lutzer/bongoForest/README.md

# BONGO FOREST

### Important

* Dont run arduino pros on more than 5 V on the RAW Pin. use seperate voltage regulator or **they will burn**.
