lutzer/bongoForest/dev/platformio/remote_direct_control/README.md

# Direct RF Control

* ID can be specified in platformio.ini as build flags

#### Upload

```bash
$ pio run --target upload
```

#### Monitoring

```bash
$ pio device monitor
```
