lutzer/bongoForest/dev/platformio/slave_drum/README.md

# Slave Drum Receiver

* ID and type of the drum can be specified in platformio.ini as build flags

#### Upload

```bash
$ pio run --target upload
```

#### Monitoring

```bash
$ pio device monitor
```
