lutzer/bongoForest/dev/platformio/master_drum/README.md

# Master Drum Sensor and RF Sender

#### Upload

```bash
$ pio run --target upload
```

#### Monitoring

```bash
$ pio device monitor
```
