lutzer/bongoForest/docs/solenoid.md

# Solenoids

### how to connect

https://www.bc-robotics.com/tutorials/controlling-a-solenoid-valve-with-arduino/

#### BOM

- 1 x [TIP120 Darlington Transistor](https://www.bc-robotics.com/shop/tip120-darlington-transistor/)
- 1 x [1K Ohm Resistor](https://www.bc-robotics.com/shop/14-watt-resistor/)
- 1 x [1N4001 Diode](https://www.bc-robotics.com/shop/diode-rectifier-1a-50v/)
