lutzer/bongoForest/docs/BOM.md

# BOM

## Slave pcbs

* [ ] 10 pin header female  2x4
* [ ] 20 pin header female 1x12
* [ ] 10 x arduino pro mini 3.3V
* [ ] 10x nrf240L radio transceiver
* [ ] 20x TIP120
* [ ] 20x Voltage Regulator
* [ ] 20x 1kOhm Resistors
* [ ] 10x Diode
* [ ] 10x Schotky diode
* [ ] 40x Leds + Resistors
* [ ] 10x 10uF Capacitor
* [ ] Strom schraub verbinder
* [ ] 20x pin header male 1x2

### Drums

Solenoids
