lutzer/bongoForest/pcbs/slave_drum/bom_for_slaves.md

# BOM for slave pcbs

* [ ] 1 pin header female  2x4
* [ ] 2 pin header female 1x12
* [ ] 1 x arduino pro mini 3.3V
* [ ] 1 nrf240L radio transceiver
* [ ] 2 TIP120
* [ ] 1 Voltage Regulator
* [ ] 2 1kOhm Resistors
* [ ] 1 Diode
* [ ] 2 Schotky diode
* [ ] 4 Leds + Resistors
* [ ] 1 10uF Capacitor
* [ ] Screw Terminal 2pin
* [ ] 2 pin header male 1x2
