lutzer/bongoForest/stls/pcb_case_top_rotated.stl

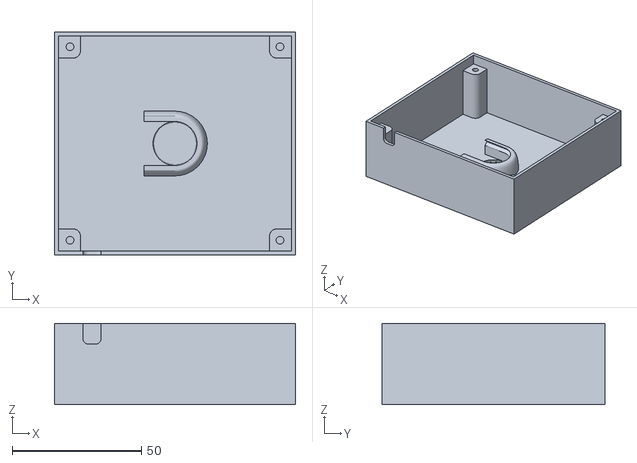
[picture p3: CAD file, 2018-07-22]
stls/pcb_case_top_rotated.stl
93.2 x 86.2 x 31.5
