lutzer/bongoForest/stls/Piezzo_clamp_v1.stl

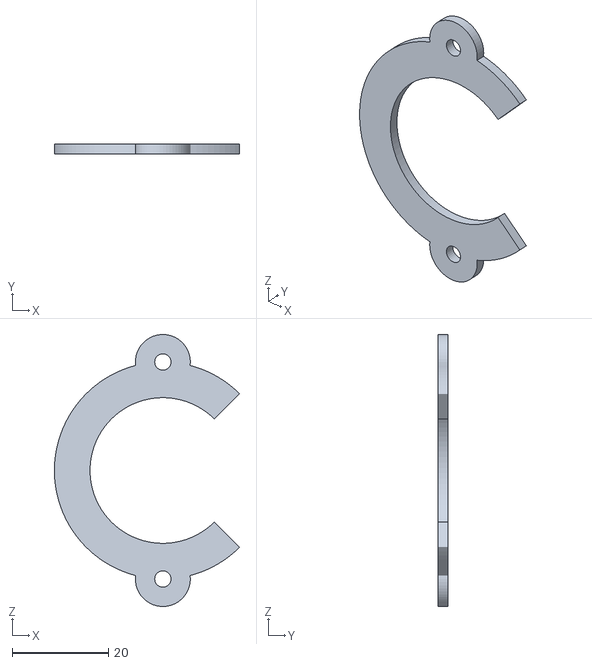
[picture p4: CAD file, 2018-07-22]
stls/Piezzo_clamp_v1.stl
38.4 x 2.00 x 56.4
