lutzer/bongoForest/stls/Piezzo_platform_v1.stl

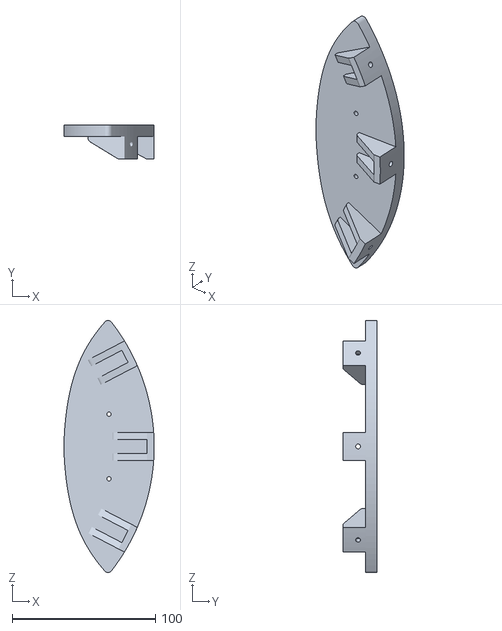
[picture p5: CAD file, 2018-07-22]
stls/Piezzo_platform_v1.stl
63.0 x 24.0 x 175.6
