lutzer/bongoForest/stls/pcb_case_bottom.stl

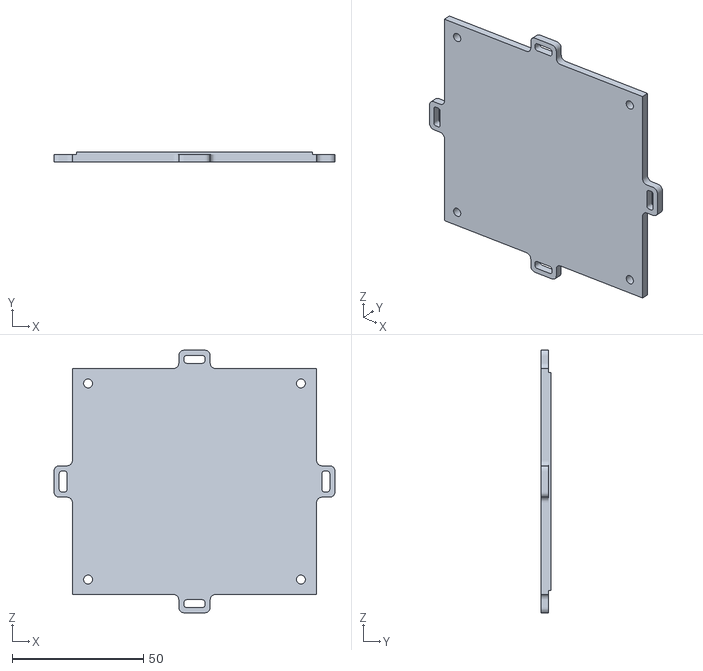
[picture p6: CAD file, 2018-07-21]
stls/pcb_case_bottom.stl
107.2 x 4.00 x 100.2
