lutzer/bongoForest/stls/clamp_14.stl

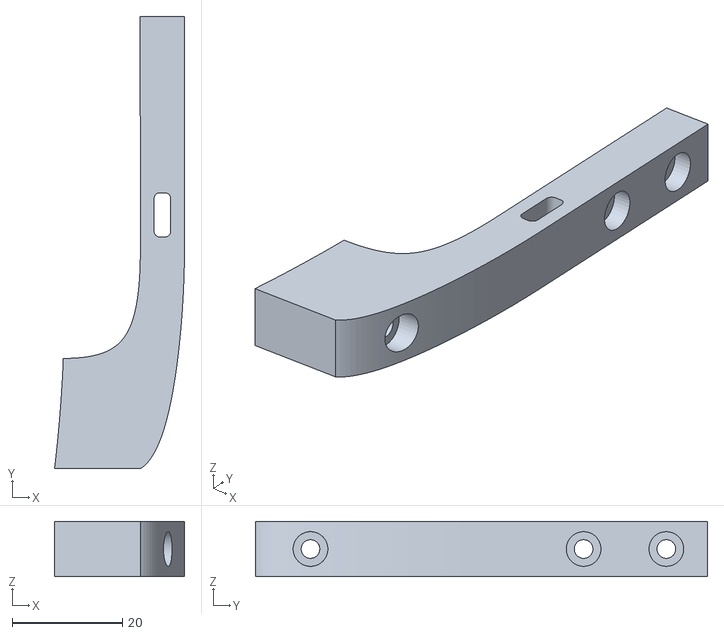
[picture p7: CAD file, 2018-07-21]
stls/clamp_14.stl
23.6 x 82.0 x 10.0
