lutzer/bongoForest/stls/holder_125mm.stl

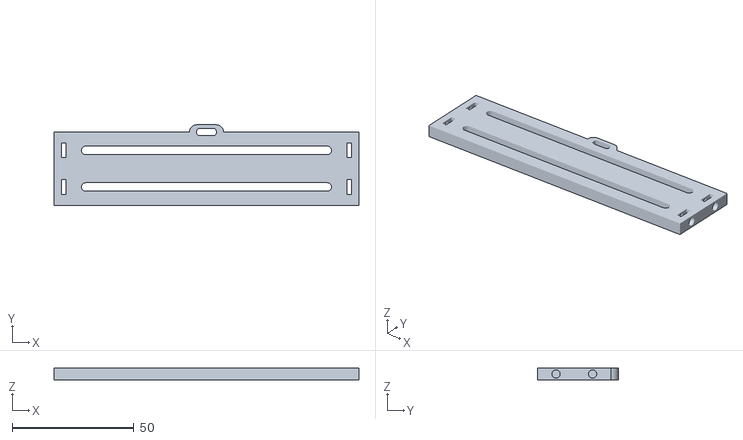
[picture p8: CAD file, 2018-07-21]
stls/holder_125mm.stl
125.0 x 33.0 x 5.00
