lutzer/bongoForest/stls/holder_116mm.stl

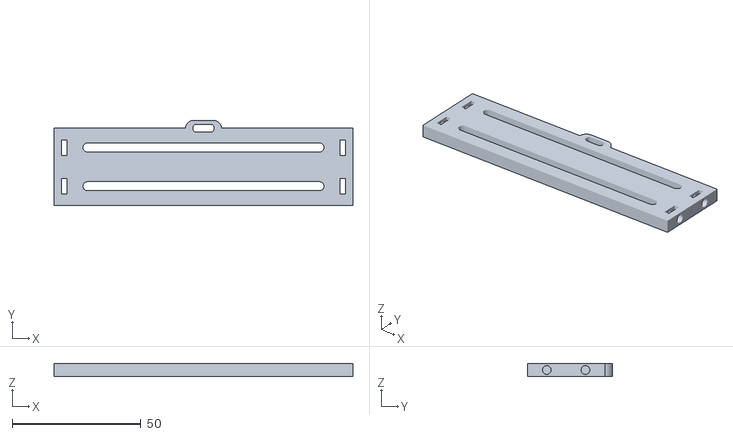
[picture p9: CAD file, 2018-06-27]
stls/holder_116mm.stl
116.0 x 33.0 x 5.00
