lutzer/bongoForest/stls/clamp_10mm.stl

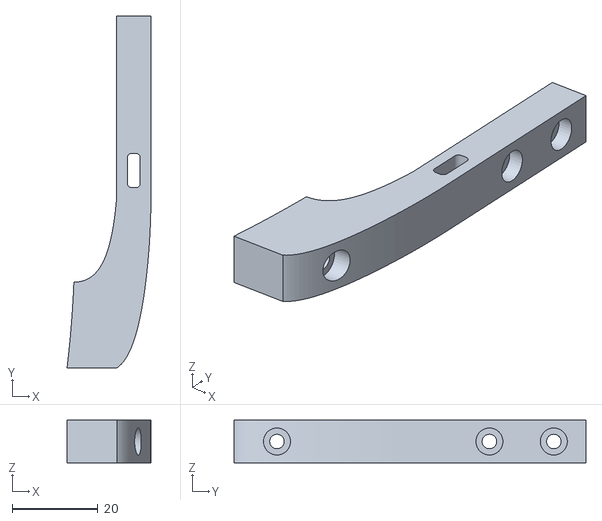
[picture p10: CAD file, 2018-06-25]
stls/clamp_10mm.stl
19.6 x 82.0 x 10.0
