lutzer/bongoForest/stls/striker_round.stl

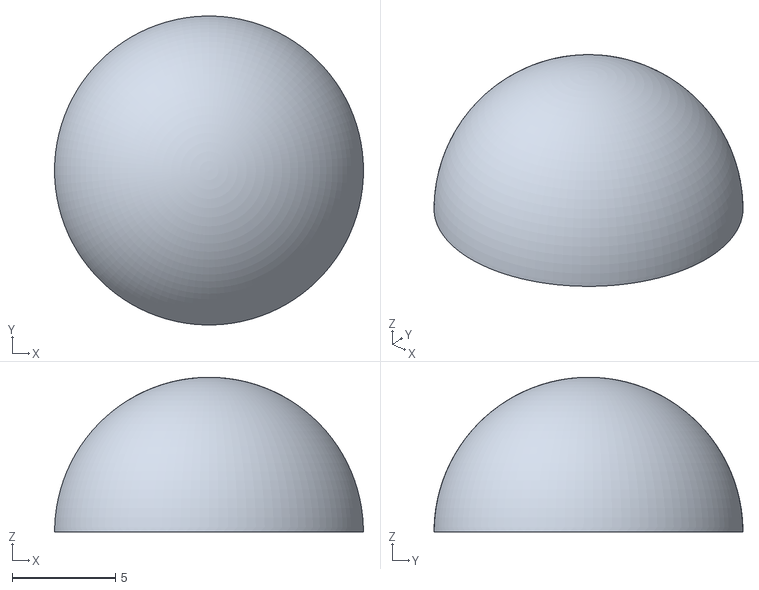
[picture p11: CAD file, 2018-06-09]
stls/striker_round.stl
15.0 x 15.0 x 7.50
