lutzer/bongoForest/(list of files, cad)

Other CAD files:
stls/pcb_case_top.stl
stls/pcb_case_bottom_rotated.stl
