lutzer/bongoForest/pcbs/master_drum/exported/master_drum.pdf

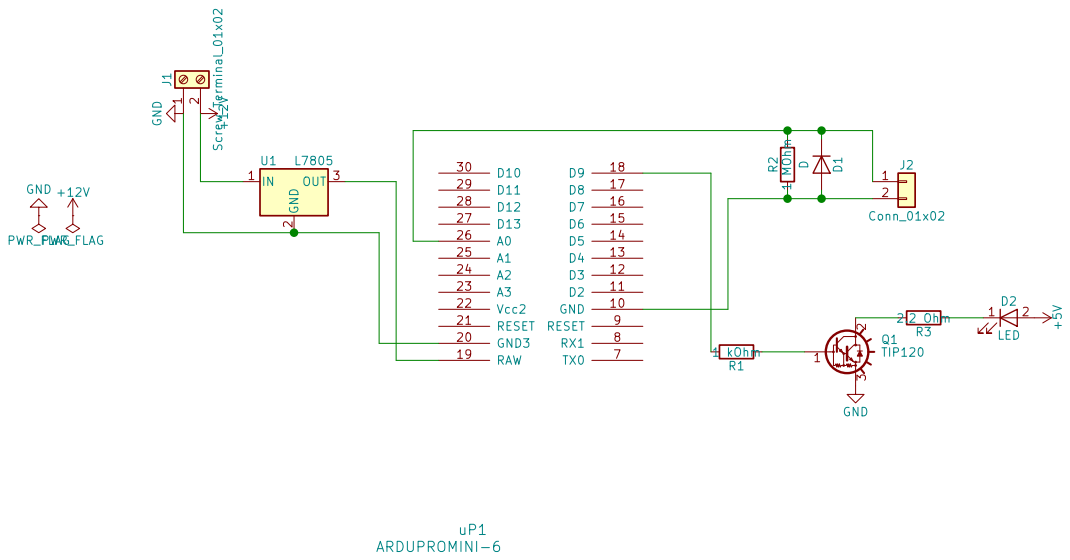
[picture p12: page 1]

2 OUT 3 U1 L7805 TX0 7 RX1 8 RESET 9 GND 10 GND3 20 D10 30 D2 11 RESET 21 D3 12 Vcc2 22 D4 13 A3 23 D5 14 A2 24 D6 15 A1 25 D7 16 A0 26 D8 17 D13 27 D9 18 D12 28 RAW 19 D11 29uP1 ARDUPROMINI-6
