lutzer/bongoForest/pcbs/slave_drum/export/slave_drum-B.Cu.pdf

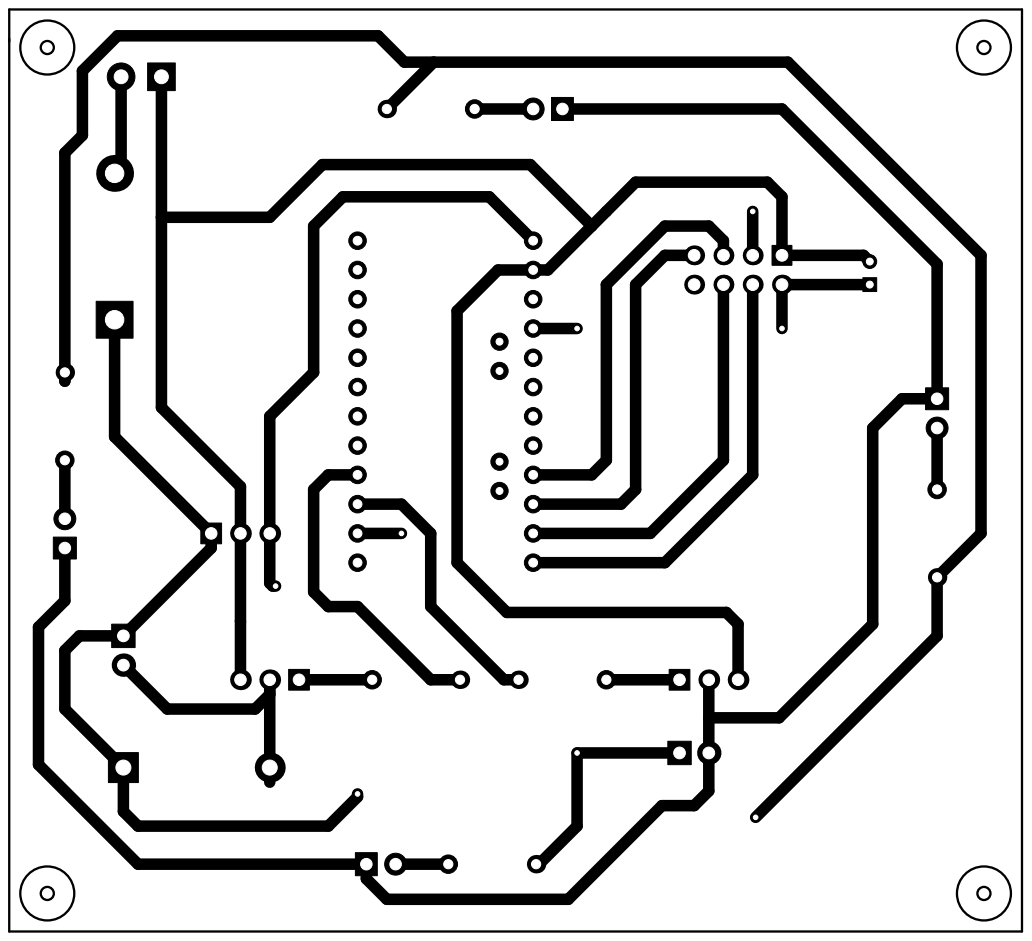
[picture p13: page 1]
