lutzer/bongoForest/pcbs/slave_drum/export/slave_drum-F.Cu.pdf

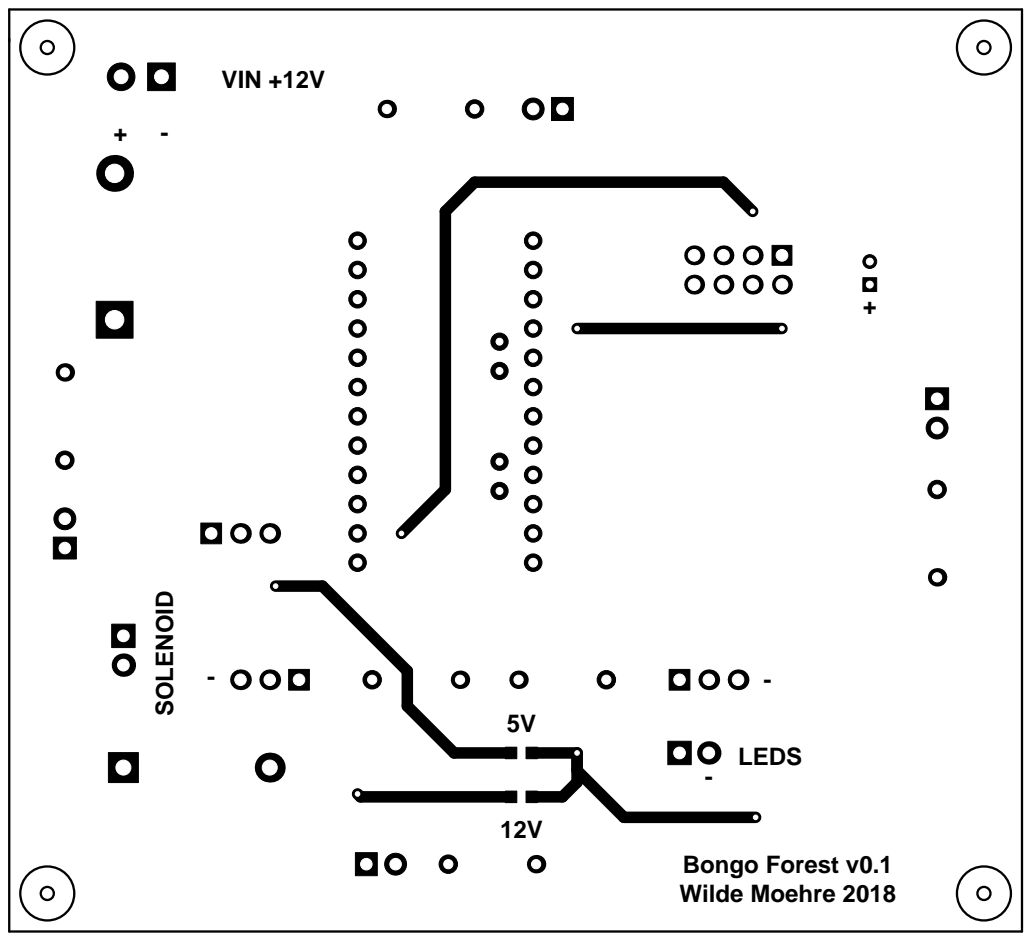
[picture p14: page 1]
