lutzer/bongoForest/pcbs/slave_drum/slave_drum.kicad_pcb

## KiCad design pcbs/slave_drum/slave_drum.kicad_pcb (2018-06-18)

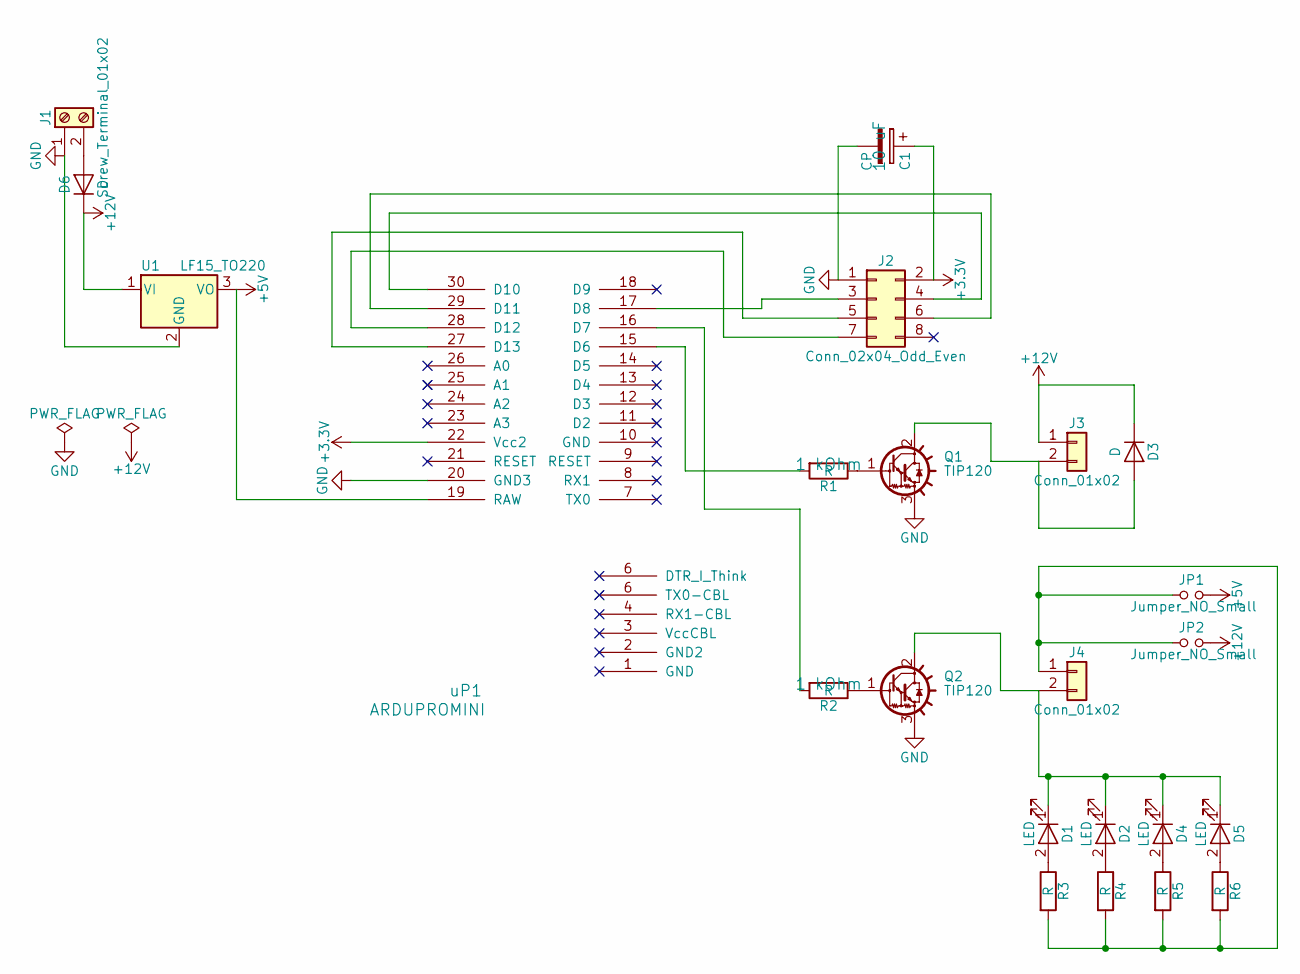
[picture p15: schematic slave_drum.sch]

Parts:
C1: CP; CP_Radial_D5.0mm_P2.00mm
D1, D2, D4, D5: LED; LED-5MM
D3: D; D_DO-201_P12.70mm_Horizontal
D6: D; D_DO-201AD_P12.70mm_Horizontal
J1: Screw_Terminal_01x02; TerminalBlock_4UCON_19963_02x3.5mm_Straight
J2: Conn_02x04_Odd_Even; Pin_Header_Straight_2x04
J3, J4: Conn_01x02; Pin_Header_Straight_1x02
JP1, JP2: Jumper_NO_Small; SOLDER-JUMPER_1-WAY_FAR
Q1, Q2: TIP120; TO-220_Vertical
R1, R2, R3, R4, R5, R6: R; R_Axial_DIN0207_L6.3mm_D2.5mm_P7.62mm_Horizontal
U1: LF15_TO220; TO-220_Horizontal
uP1: ARDUPROMINI; ArduProMini-6

Connections:
+3V3: C1.1, J2.2, uP1.22 (Vcc2)
+5V: JP1.2, U1.3 (VO), uP1.19 (RAW)
+12V: D3.1 (K), D6.1 (K), J3.1, JP2.2, U1.1 (VI)
GND: C1.2, J1.1, J2.1, Q1.3 (E), Q2.3 (E), U1.2 (GND), uP1.20 (GND3)
unnamed: D1.1 (K), D2.1 (K), D4.1 (K), D5.1 (K), J4.2, Q2.2 (C)
unnamed: D1.2 (A), R3.1
unnamed: D2.2 (A), R4.1
unnamed: D3.2 (A), J3.2, Q1.2 (C)
unnamed: D4.2 (A), R5.1
unnamed: D5.2 (A), R6.1
unnamed: D6.2 (A), J1.2
unnamed: J2.3, uP1.17 (D8)
unnamed: J2.4, uP1.30 (D10)
unnamed: J2.5, uP1.27 (D13)
unnamed: J2.6, uP1.29 (D11)
unnamed: J2.7, uP1.28 (D12)
unnamed: J4.1, JP1.1, JP2.1, R3.2, R4.2, R5.2, R6.2
unnamed: Q1.1 (B), R1.1
unnamed: Q2.1 (B), R2.1
unnamed: R1.2, uP1.15 (D6)
unnamed: R2.2, uP1.16 (D7)

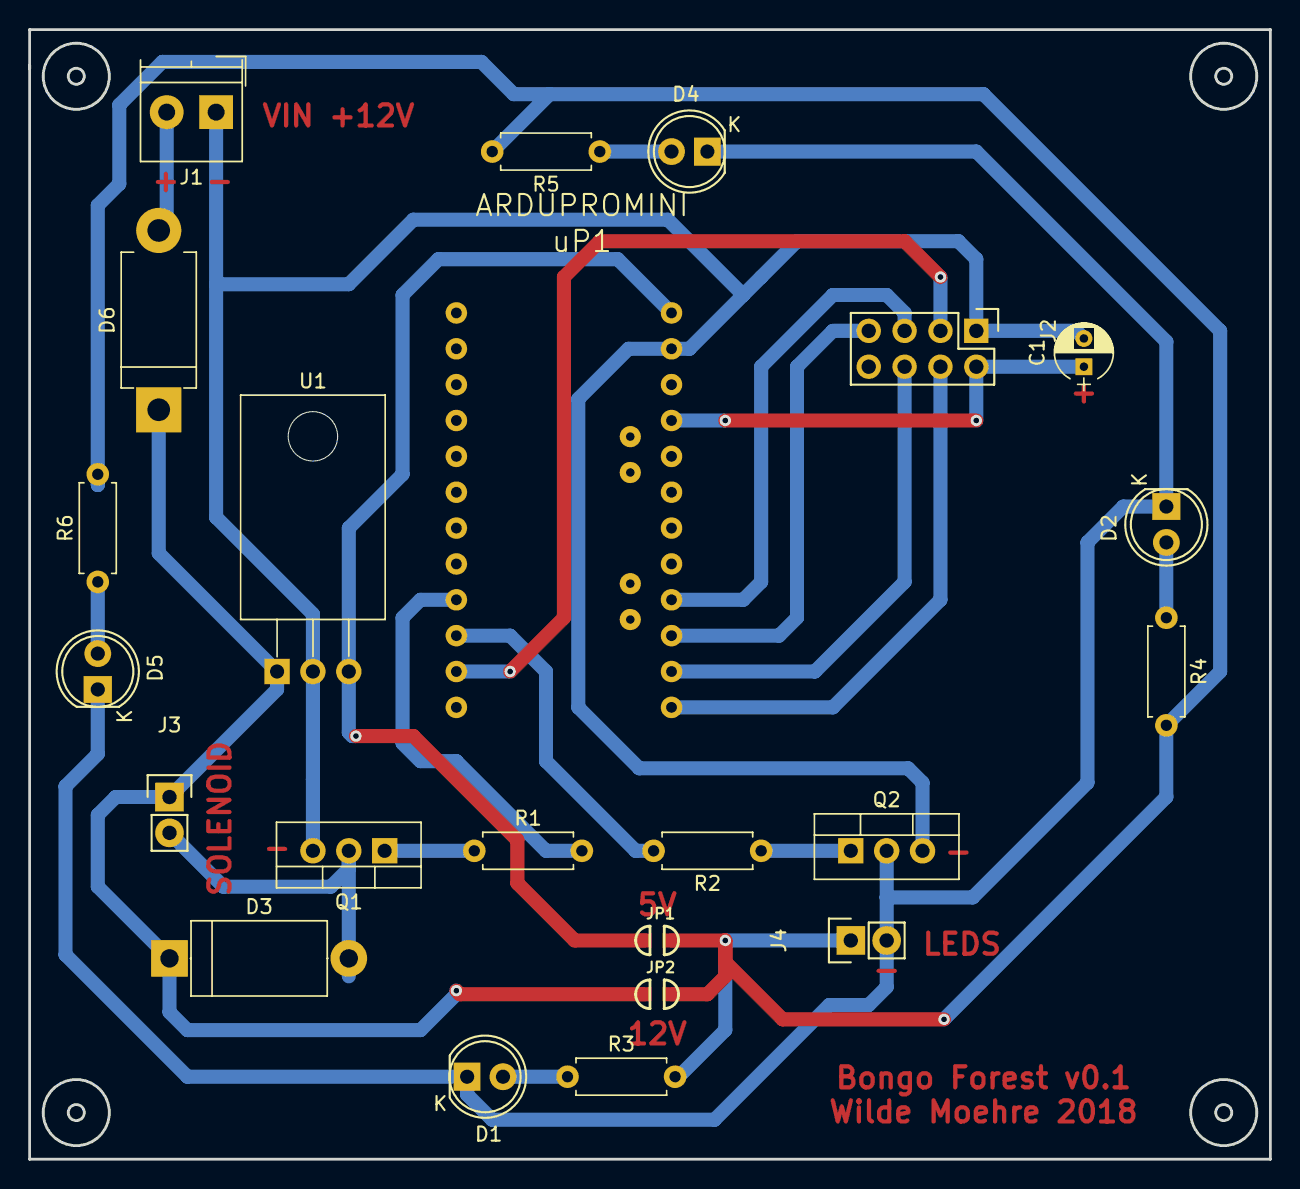
[picture p16: board slave_drum.kicad_pcb from above]

Board: 2 copper layers, 87.9 x 80.0 mm, 23 parts (0 on the bottom side), 21 nets.
