lutzer/bongoForest/dev/platformio/remote_direct_control/src/defines.h

#define BOARD_ID _ID

#define MIN_TRIGGER_TIME 0
#define MAX_TRIGGER_TIME 50

#define PIN_A 7 // LED
#define PIN_B 6 // LASER

#define RADIO_CE_PIN 8
#define RADIO_CSN_PIN 10
