lutzer/bongoForest/dev/platformio/ConfigSender/src/RfMessage.h

/**
 * @Author: Lutz Reiter [http://www.lu-re.de] <lutz>
 * @Date:   2018-07-22T20:22:48+02:00
 * @Project: Brain String
 * @Last modified by:   lutz
 * @Last modified time: 2018-07-22T20:23:22+02:00
 */

 struct RfMessage {
  char type;
  uint16_t value;
  uint8_t id;
 };
