lutzer/bongoForest/(commit log)

2018-06-09 created test patches
    [clamp.stl, rail.stl, striker_flat.stl, striker_half.stl, striker_round.stl]
2018-06-16 added slave drum schematic
    [slave_drum.kicad_pcb, slave_drum.sch]
2018-06-17 finished slave pcb
    [slave_drum.sch]
2018-06-18 added bom
    [slave_drum.sch]
2018-06-22 changed arduino sketches
2018-06-25 changed 3d models
    [clamp.stl, holder.stl, rail.stl, striker_flat.stl, striker_half.stl]
2018-06-27 updated holder and bom
    [holder.stl]
2018-07-01 add master drum schematic
    [master_drum.kicad_pcb, master_drum.sch, slave_drum.kicad_pcb, slave_drum.sch]
2018-07-17 bongoForest | master - signal filtering logic, visualization and configuration
2018-07-21 added stls
    [clamp_10mm.stl, clamp_14.stl, holder_116mm.stl, holder_125mm.stl, pcb_case_bottom.stl, pcb_case_bottom_rotated.stl, pcb_case_top.stl, pcb_case_top_rotated.stl]
2018-07-21 changed stls for pcb case
    [pcb_case_bottom.stl, pcb_case_bottom_rotated.stl, pcb_case_top.stl, pcb_case_top_rotated.stl]
2018-07-22 bongoForest | master - created Main drum platform for printing
    [Piezzo_clamp_v1.stl, Piezzo_platform_v1.stl]
2018-07-22 changed top case
    [pcb_case_top.stl, pcb_case_top_rotated.stl]
2018-07-25 bongoForest | master - update filtering mapping
2019-07-19 bongoForest | master - basic procedding laser controller
